sneak-thief/Sneaky-Gestures-V2/hardware/Sneaky-Gestures-V2-Schematic_V1.0.pdf

## Sneaky Gestures V2

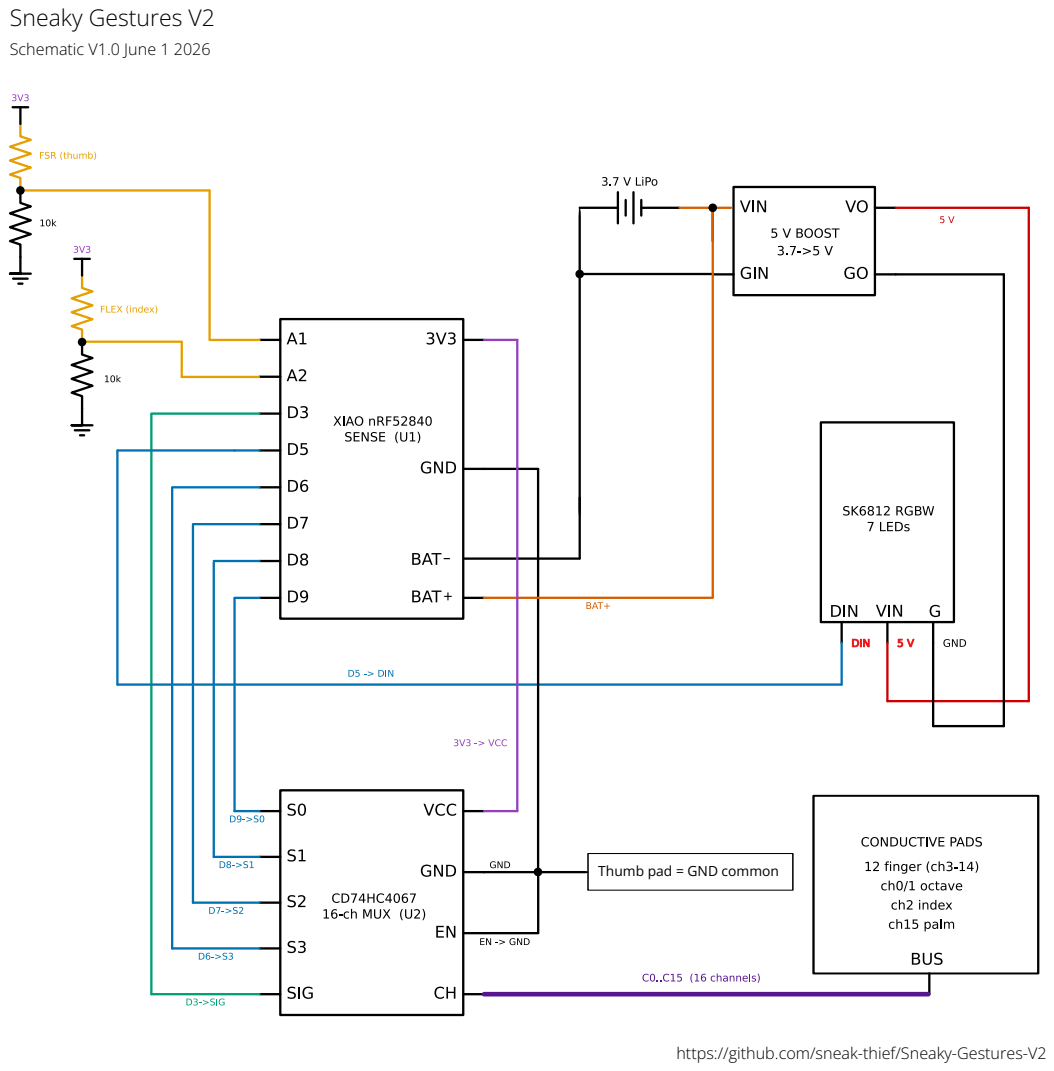
[picture p22: page 1]
Schematic V1.0 June 1 2026

Thumb pad = GND common

https://github.com/sneak-thief/Sneaky-Gestures-V2
