sneak-thief/Sneaky-Gestures-V2/(commit log)

2024-01-01 Added scale quantizer from ACSensorizer
    Ported C code from MIDIbox AC Sensorizer for MIDI note scale quantizing
2024-01-01 Added quantizer from MIDIbox AC Sensorizer
    MIDI note scale quantizer from MIDIbox AC Sensorizer
2024-01-12 First 4 gesture models added
    4 gestures captured using IMUCapture.ino and processed using the TensorFlow Lite scripts: https://colab.research.google.com/github/arduino/ArduinoTensorFlowLiteTutorials/blob/master/GestureToEmoji/arduino_tinyml_workshop.ipynb
2026-05-30 Update README.md
    Full rewrite: new features, LED display, removed tinyML references
2026-05-30 Create README_BOM.md
    Added Bill of Materials
2026-05-30 Add files via upload
    Added V1.0 schematics
2026-05-30 Add files via upload
    Added LED reference mode documentation
2026-05-30 Delete hardware/Sneaky-Gestures-V2-Schematic_V1.0.svg
    Deleted unneeded file
2026-05-30 Add files via upload
    Added schematic PNG
2026-05-30 Update README.md
    Added BOM/schematics link
2026-05-30 Add files via upload
    Added code for LED animation, pitch shifting to match tempo changes and serial debug
2026-05-31 Rename 0-glove-bom.jpg to 00-glove-bom.jpg
    Renamed for ordering purposes
2026-05-31 Delete build/00-glove-bom.jpg
    Deleting for ordering purposes
2026-05-31 Delete build/1-4067-xiao-sense-mount.jpg
    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
2026-05-31 Delete build/4-glove-wiring.jpg
    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
2026-05-31 Delete build/5-glove-xiao-sense-wiring.jpg
    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
2026-05-31 Delete build/7-glove-wiring4.jpg
    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
2026-05-31 Delete build/8-glove-wiring2.jpg
    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
2026-05-31 Delete build/9-glove-wiring3.jpg
    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
2026-05-31 Update LED_Mode_Reference.html
    Updated links
2026-05-31 Update README.md
    Added JST connectors to bom
2026-06-01 Update README.md
    Added serial patch save/load info and patch load/save LED confirmation info
2026-06-01 Update LedDisplay.cpp
    Added preset load/save blink confirmation
2026-06-01 Update LedDisplay.h
    Updated description
2026-06-01 Update README.md
    Updated pitch bend description
2026-06-01 Update LED_Mode_Reference.html
    Added load/save confirm LED flash, updated battery level view
2026-06-01 Update LED_Mode_Reference.html
    Remove external CSS reference
2026-06-01 Update README.md
    Added note wiring description
2026-06-02 Update README.md
    Updated charging description
2026-06-02 Update README.md
    Updated LED behaviour on pairing description
2026-06-03 Update main.cpp
    Increased debounce timing, increased the NoteOffRetry from 100 to 150ms later, added 2 more consecutive NoteOff commands to prevent hanging notes
    [main.cpp]
2026-06-04 Update main.cpp
    Corrected MIDI CC typo
    [main.cpp]
2026-06-13 Update main.cpp
    Disabled MIDI "all notes off" every 1s (was tested to prevent hanging notes)
    [main.cpp]
2026-06-30 Update README.md
    Added analog input low-pass filtering and MIDI CC interpolation
2026-06-30 Add files via upload
    Enabled IMU on-board filtering and "One-Euro Filter" low-pass analog input filter.
2026-06-30 Update main.cpp
    Enabled IMU on-board filtering and "One-Euro Filter" low-pass analog input filter. Added MIDI CC interpolation. Added BLE connection status to serial debug. Added fast 7.5ms BLE connection interval request. Blocked BLE radio from transmitting while SK6812 LED data packets are sent to prevent packet corruption
    [main.cpp]
2026-06-30 Update LedDisplay.cpp
    Gated BLE radio while SK6812 data packets are sent to prevent corruption (LED flickering), optimized flex LED display
    [LedDisplay.cpp]
2026-06-30 Update LED_Mode_Reference.html
    Changed CC74 to CC11
2026-07-01 Update main.cpp
    Added defines to enable/disable MIDI CC and AT interpolation, reduced amount of AT messages (decreased interpolation) to prevent buffer lags
    [main.cpp]
